patrick-electrick/mimeofreq/hardware/LTspice/mimf_peripherals.asc

C1: cap; 0.1µ
C2: cap; 100n
C3: cap; 10µ
C4: cap; 0.1µ
C5: cap; 100p
C6: cap; 1n
C7: cap; 470p
C8: cap; 0.1µ
C9: cap; 1µ
C10: cap; 0.1µ
C21: cap; 1n
C22: cap; 470p
C27: cap; 1µ
I1: current; ""; AC 1
R1: res; 100
R2: res; 1Meg
R3: res; 1.5Meg
R4: res; 33k
R5: res; 22k
R6: res; 100k
R7: res; 12k
R8: res; 12k
R9: res; 100
R12: res; 100k
R27: res; 12k
R28: res; 12k
R33: res; 100k
U1: UniversalOpAmp2; Avol=1Meg GBW=1Meg Slew=10Meg
U3: UniversalOpAmp2; Avol=1Meg GBW=1Meg Slew=10Meg
U4: UniversalOpAmp2; Avol=1Meg GBW=1Meg Slew=10Meg
U9: UniversalOpAmp2; Avol=1Meg GBW=1Meg Slew=10Meg
V1: voltage; SINE(0 1 1k); AC 1
V3: voltage; SINE(0 0.1 1k 0 0 180); AC 1 180
V4: voltage; 3.3
Named nets: 0, IN_JACK, OUT_SEED, 3V3, 1V65, OUT_JACK
;tran 0 22m 20m
.ac dec 128 1 10Meg
.step PARAM x list 10k 100k 1Meg 10Meg 100Meg
INPUT BUFFER
OUTPUT BUFFER
3V3/2 BIAS
MIMEOFREQ PERIPHERALS
