patrick-electrick/mimeofreq/(commit log)

2026-10-21 KiCad reorganization; more graphics.
    [mimeofreq.kicad_pcb]
2026-10-21 Reverted attempt at ADC smoothing.
    [mimeofreq.cpp]
2026-10-22 Subtitle text; standard bold thickness.
    [mimeofreq.kicad_pcb]
2026-10-22 Added identification properties for KiCad schematic drawing sheets.
    [input_buffer.kicad_sch, mimeofreq.kicad_sch, output_buffer.kicad_sch, power_conditioner.kicad_sch]
2026-11-06 Schematic edited: C1 and C3 values swapped.
    [input_buffer.kicad_sch, mimeofreq.kicad_pcb, mimeofreq.kicad_sch, output_buffer.kicad_sch, power_conditioner.kicad_sch]
2026-11-07 C1 value changed to 15uF from 10uF.
    [mimeofreq.kicad_pcb, mimeofreq.kicad_sch]
